als21021/stm32-plant-monitor/README.md

# stm32-plant-monitor
STM32F411 기반 토양 수분·조도 센서 자동 급수 시스템 (C, FreeRTOS)
