als21021/stm32-plant-monitor/hardware/stm32-plant-monitor.kicad_sch

## KiCad design hardware/stm32-plant-monitor.kicad_sch (2026-10-15)

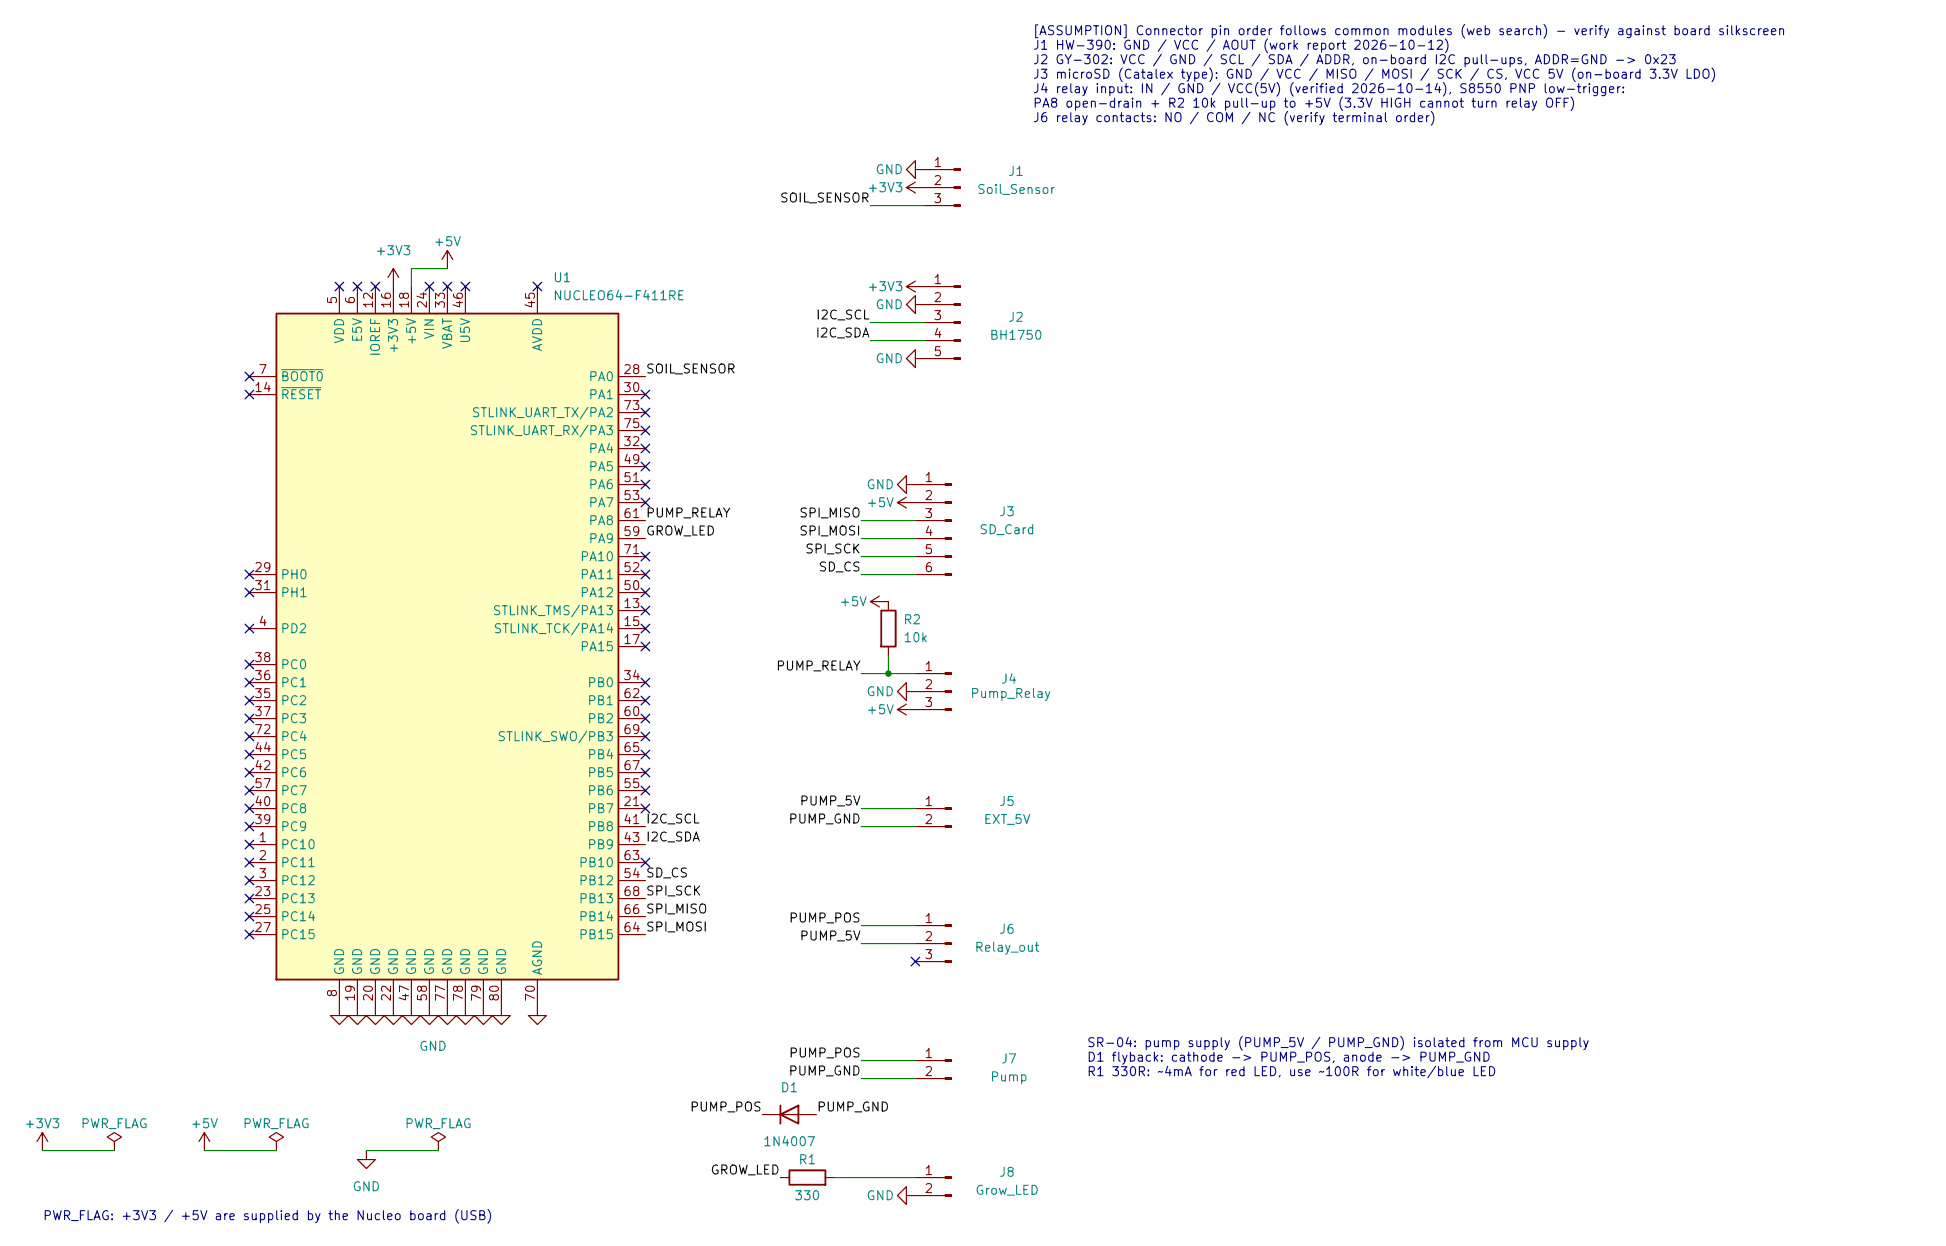
[picture p1: schematic stm32-plant-monitor.kicad_sch]

Parts:
D1: 1N4007
J1: Soil_Sensor
J2: BH1750
J3: SD_Card
J4: Pump_Relay
J5: EXT_5V
J6: Relay_out
J7: Pump
J8: Grow_LED
R1: 330
R2: 10k
U1: NUCLEO64-F411RE; ST_Morpho_Connector_144_STLink

Connections:
+3V3: J1.2, J2.1, U1.16 (+3V3)
+5V: J3.2, J4.3, R2.1, U1.18 (+5V)
GND: J1.1, J2.2, J2.5, J3.1, J4.2, J8.2, U1.8 (GND), U1.19 (GND), U1.20 (GND), U1.22 (GND), U1.47 (GND), U1.58 (GND), U1.70 (AGND), U1.77 (GND), U1.78 (GND), U1.79 (GND), U1.80 (GND)
GROW_LED: R1.1, U1.59 (PA9)
I2C_SCL: J2.3, U1.41 (PB8)
I2C_SDA: J2.4, U1.43 (PB9)
unnamed: J8.1, R1.2
PUMP_5V: J5.1, J6.2
PUMP_GND: D1.2 (A), J5.2, J7.2
PUMP_POS: D1.1 (K), J6.1, J7.1
PUMP_RELAY: J4.1, R2.2, U1.61 (PA8)
SD_CS: J3.6, U1.54 (PB12)
SOIL_SENSOR: J1.3, U1.28 (PA0)
SPI_MISO: J3.3, U1.66 (PB14)
SPI_MOSI: J3.4, U1.64 (PB15)
SPI_SCK: J3.5, U1.68 (PB13)

Notes on the sheet:
PWR_FLAG: +3V3 / +5V are supplied by the Nucleo board (USB)
[ASSUMPTION] Connector pin order follows common modules (web search) - verify against board silkscreen J1 HW-390: GND / VCC / AOUT (work report 2026-10-12) J2 GY-302: VCC / GND / SCL / SDA / ADDR, on-board I2C pull-ups, ADDR=GND -> 0x23 J3 microSD (Catalex type): GND / VCC / MISO / MOSI / SCK / CS,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
SR-04: pump supply (PUMP_5V / PUMP_GND) isolated from MCU supply D1 flyback: cathode -> PUMP_POS, anode -> PUMP_GND R1 330R: ~4mA for red LED, use ~100R for white/blue LED
