als21021/stm32-plant-monitor/Core/Inc/main.h

#define B1_Pin GPIO_PIN_13
#define B1_GPIO_Port GPIOC
#define SOIL_SENSOR_Pin GPIO_PIN_0
#define SOIL_SENSOR_GPIO_Port GPIOA
#define USART_TX_Pin GPIO_PIN_2
#define USART_TX_GPIO_Port GPIOA
#define USART_RX_Pin GPIO_PIN_3
#define USART_RX_GPIO_Port GPIOA
#define LD2_Pin GPIO_PIN_5
#define LD2_GPIO_Port GPIOA
#define SD_CS_Pin GPIO_PIN_12
#define SD_CS_GPIO_Port GPIOB
#define PUMP_RELAY_Pin GPIO_PIN_8
#define PUMP_RELAY_GPIO_Port GPIOA
#define GROW_LEDs_Pin GPIO_PIN_9
#define GROW_LEDs_GPIO_Port GPIOA
#define TMS_Pin GPIO_PIN_13
#define TMS_GPIO_Port GPIOA
#define TCK_Pin GPIO_PIN_14
#define TCK_GPIO_Port GPIOA
#define SWO_Pin GPIO_PIN_3
#define SWO_GPIO_Port GPIOB
#define BH1750_SCL_Pin GPIO_PIN_8
#define BH1750_SCL_GPIO_Port GPIOB
#define BH1750_SDA_Pin GPIO_PIN_9
#define BH1750_SDA_GPIO_Port GPIOB
