als21021/stm32-plant-monitor/(commit log)

2026-09-12 gitignore 추가
2026-09-16 docs:.gitattributes 추가
2026-09-16 docs:.gitattributes 확장자 변경
2026-09-20 chore: STM32CubeIDE 프로젝트 초기 생성
2026-09-29 chore: CubeMX 초기 페리페럴 설정 및 코드 생성 (#3)
    - 클럭: HSE 바이패스(ST-LINK MCO 8MHz), SYSCLK 100MHz, APB1 50MHz / APB2 100MHz
    - I2C1(PB8/PB9): BH1750 조도 센서용, 100kHz
    - ADC1 IN0(PA0): 토양 습도 센서용, 분주 /4(25MHz, ADC 최대 클럭 초과 방지), 샘플링 84 cycles
    - GPIO 출력: PA8 PUMP_RELAY, PA9 GROW_LED (초기값은 각 부품 비활성 레벨)
    - SPI2(PB13/14/15) + PB12 SD_CS: SD카드용, 분주 /128(초기화 400kHz 이하 규격)
    - USART2(PA2/PA3): 디버그 출력, 115200 8N1
    - IWDG: 약 2초 타임아웃, MX_IWDG_Init 자동 호출 제외 (app_init에서 수동 시작 예정)
    - FatFs는 로깅 작업 시 추가 예정
2026-09-30 Chore/spi2 pin config (#4)
    * chore: CubeMX 초기 페리페럴 설정 및 코드 생성
    - FatFs는 로깅 작업 시 추가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
2026-09-30 feat: UART printf 리다이렉션 추가 (#5)
2026-10-04 feat: 모듈 헤더 및 스텁 뼈대 추가 (#7)
2026-10-14 Docs/kicad schematic (#8)
    * chore: KiCad 백업, 캐시 파일 .gitignore 추가
    * chore: CubeIDE 빌드 결과물 및 KiCad 히스토리 .gitignore 추가
    * docs: KiCad 회로도 초안 추가
    토양 습도 센서 커넥터 핀 순서는 미확인 상태
    * docs: Kicad 회로도 초안 추가 (센서/I2C 연결)
    * chore: KiCad 로컬 히스토리 폴더 gitignore 추가
    * docs: 회로도 추가
    * docs: 회로도 신호선 연결 및 펌프 전원 분리
2026-10-14 feat: 토양습도 센서 ADC 읽기 및 변환 추가 (#9)
    * feat: 모듈 헤더 및 스텁 뼈대 추가
    * feat: 토양 습도 센서 ADC 읽기 및 변환 추가
    * docs: soil_sensor.c 설명 주석 추가
    * fix: 토양습도 센서 건조/침수 기준값 실측값으로 수정
    * docs: config.h 명세서 미정 표시 제거
    * fix: 풀다운 저항 추가에 따른 토양습도 기준값 수정
    원인: PA0 680kΩ 풀다운 장착으로 센서 출력 감소 (DRY 3400->3185, WET 1270->1210)
2026-10-15 Chore: pump relay open drain (#10)
    * chore: 펌프 릴레이 핀 오픈 드레인 설정 변경
    원인: Low 트리거 PNP 모듈 (VCC 5V)에 3.3V HIGH를 주면 릴레이가 꺼지지 않음
    * docs: 회로도 릴레이 입력 핀 순서 수정 및 풀업 추가
